scottsun95/power_converter/BoM.xlsx

Item | Designator | Supplier | Supplier ID | Part # | Qty/Board | Unit Price | Link
100uF Capacitor 1210 | C7 | Digikey | 1276-3364-1-ND | CL32A107MPVNNNE | 1 | $1.06 | https://www.digikey.com/short/jz1t50
Teensy 3.5 | U1 | Digikey | 1568-1443-ND | DEV-14055 | 1 | $26.25 | https://www.digikey.com/short/jzmt8m
Low Side GaN FET | M1 | Digikey | 917-1084-1-ND | EPC2012C | 1 | $2.99 | https://www.digikey.com/short/qjc7hc
High Side GaN FET | M2 | Mouser | 499-GS66506T-E01-MR | GS66506T-E01-MR | 1 | $17.17 | https://www.mouser.com/ProductDetail/GaN-Systems/GS66506T-E01-MR/
1kV Fast Diode | D2-4 | Digikey | HS1MLWRVGCT-ND | HS1MLW RVG | 3 | $0.33 | https://www.digikey.com/short/jzmz47
Gate Driver | U2-3 | Digikey | LM5114BMF/NOPBCT-ND | LM5114BMF/NOPB | 2 | $1.64 | https://www.digikey.com/short/qq8j1z
3.3V Reference | P1 | Digikey | 296-26324-1-ND | REF3033AIDBZR | 1 | $1.43 | https://www.digikey.com/short/jzmz4t
10K Voltage Divider | R6 | Digikey | RM20A10K/10KPCT-ND | RM2012A-103/103-PBVW10 | 1 | $1.62 | https://www.digikey.com/short/jzmwqp
P-channel MOSFET | Q1 | Digikey | IRFTS9342TRPBFCT-ND | IRFTS9342TRPBF | 1 | $0.52 | https://www.digikey.com/short/q3v5rj
120M Resistor 1206 | R5 | Digikey | HVCB1206JDD120MCT-ND | HVCB1206JDD120M | 1 | $3.73 | https://www.digikey.com/short/q8wfb8
634K Resistor 0805 | R7 | Digikey | P634KDACT-ND | ERA-6AEB6343V | 1 | $0.36 | https://www.digikey.com/short/jzmjwv
Ideal Diode | D1 | Digikey | LTC4411ES5#TRMPBFCT-ND | LTC4411ES5#TRMPBF | 1 | $3.96 | https://www.digikey.com/short/jz1tz2
Op Amp | AR1 | Digikey | 296-40464-1-ND | OPA320SAIDBVR | 1 | $2.67 | https://www.digikey.com/short/jzm7nr
Pushbutton | S1-2 | Digikey | EG5384CT-ND | TL3365AF180QG | 2 | $0.30 | https://www.digikey.com/short/jzmzz4
LED | LED1 | Digikey | 732-4998-1-ND | 150141M173100 | 1 | $0.45 | https://www.digikey.com/short/qtq502
0.5" Standoff |  | McMaster | 93505A213 | 93505A213 | 4 | $0.36 | https://www.mcmaster.com/#93505a213/=1cdy8nv
5V Charge Pump | P2 | Digikey | LTC1754ES6-5#TRMPBFCT-ND | LTC1754ES6-5#TRMPBF | 1 | $3.53 | https://www.digikey.com/short/jzzm0h
22uF Cap 0805 | C4 | Digikey | 1276-6526-1-ND | CL21A226KOQNNNE | 1 | $0.48 | https://www.digikey.com/short/jzzhzd
10uF Cap 0805 | C5 | Digikey | 399-8013-1-ND | C0805C106M4PACTU | 1 | $0.38 | https://www.digikey.com/short/jz1tb5
1uF Cap 0603 | C3 | Digikey | 732-7919-1-ND | 885012106022 | 1 | $0.10 | https://www.digikey.com/short/jzzhm4
Coupled Inductor (Request Free Samples) | L1 | Coilcraft | CJ5143 | CJ5143 | 1 | $0.00 | https://www.coilcraft.com/cj5143.cfm
Terminal Block | H1 | Digikey | 277-2518-ND | 1792863 | 1 | $0.32 | https://www.digikey.com/short/jz994j
P Channel MOSFET | Q2 | Digikey | DMP1045U-7DICT-ND | DMP1045U-7 | 1 | $0.56 | https://www.digikey.com/short/jzhfhm
Male Headers | U1, BT1 | Adafruit | 3647 | 3647 | 1 | $5.95 | https://www.adafruit.com/product/3647
Female Headers | U1 | Adafruit | 3546 | 3646 | 1 | $5.95 | https://www.adafruit.com/product/3646
 |  |  |  |  |  | $82.11
