scottsun95/power_converter/(commit log)

2018-03-11 renamed files and added button pressing
2018-03-15 added load sensing functionality into waveform switching
2018-03-15 DMA ADC conversion working
2018-03-16 timed square not working. Checkpoint
    [converter_lib.cpp, power_converter.ino]
2018-03-17 debugging comparator buck
2018-03-17 adc tweaked to be faster and use dual sampling
2018-03-17 fixed minor merge bug
    [power_converter.ino]
2018-03-17 minor fix to timed switching
    [converter_lib.cpp, power_converter.ino]
2018-03-17 synchronized average ADC reading
2018-03-17 reverse comparator bucking not fully working
    [converter_lib.cpp, power_converter.ino]
2018-03-18 sine wave generator working with minor oscillation
    [converter_lib.cpp, converter_lib.h, power_converter.ino]
2018-05-16 remomved timer variable
2018-05-17 Added board image
2018-05-17 Added bill of materials
    [BoM.xlsx]
2018-06-05 Added Gerber design files
